scottdube/CNC_Vac_Pump/mech/Console_pcb.step

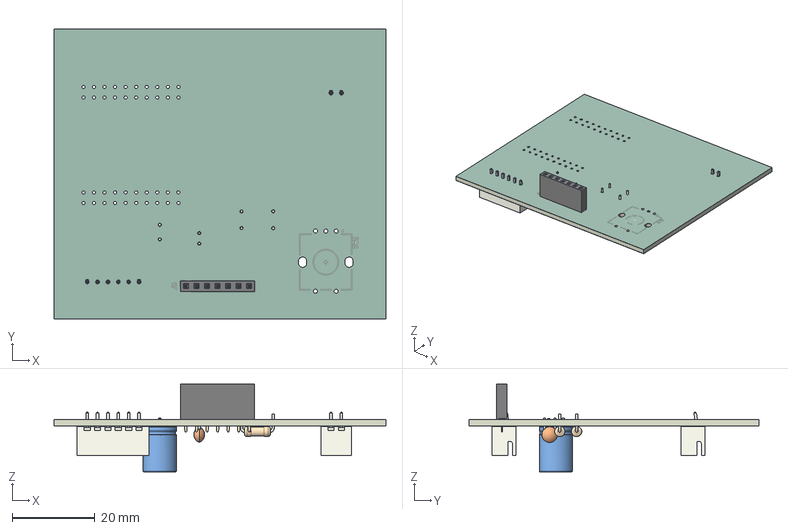
[picture p1: CAD file, 2026-08-21]
mech/Console_pcb.step
80.0 x 70.0 x 21.2 mm
PinSocket_1x07_P2.54mm_Vertical
JST_B6B_XH_A
C_Radial_D80mm_H115mm_P350mm
R_Axial_DIN0207_L63mm_D25mm_P762mm_Horizontal x 2
JST_B2B_XH_A
C_Disc_D38mm_W26mm_P250mm
Console_silkscreen x 2
Console_soldermask x 2
Console_PCB
