scottdube/CNC_Vac_Pump/PCB/Console/Console.kicad_pcb

## KiCad design PCB/Console/Console.kicad_pcb (2026-08-21)

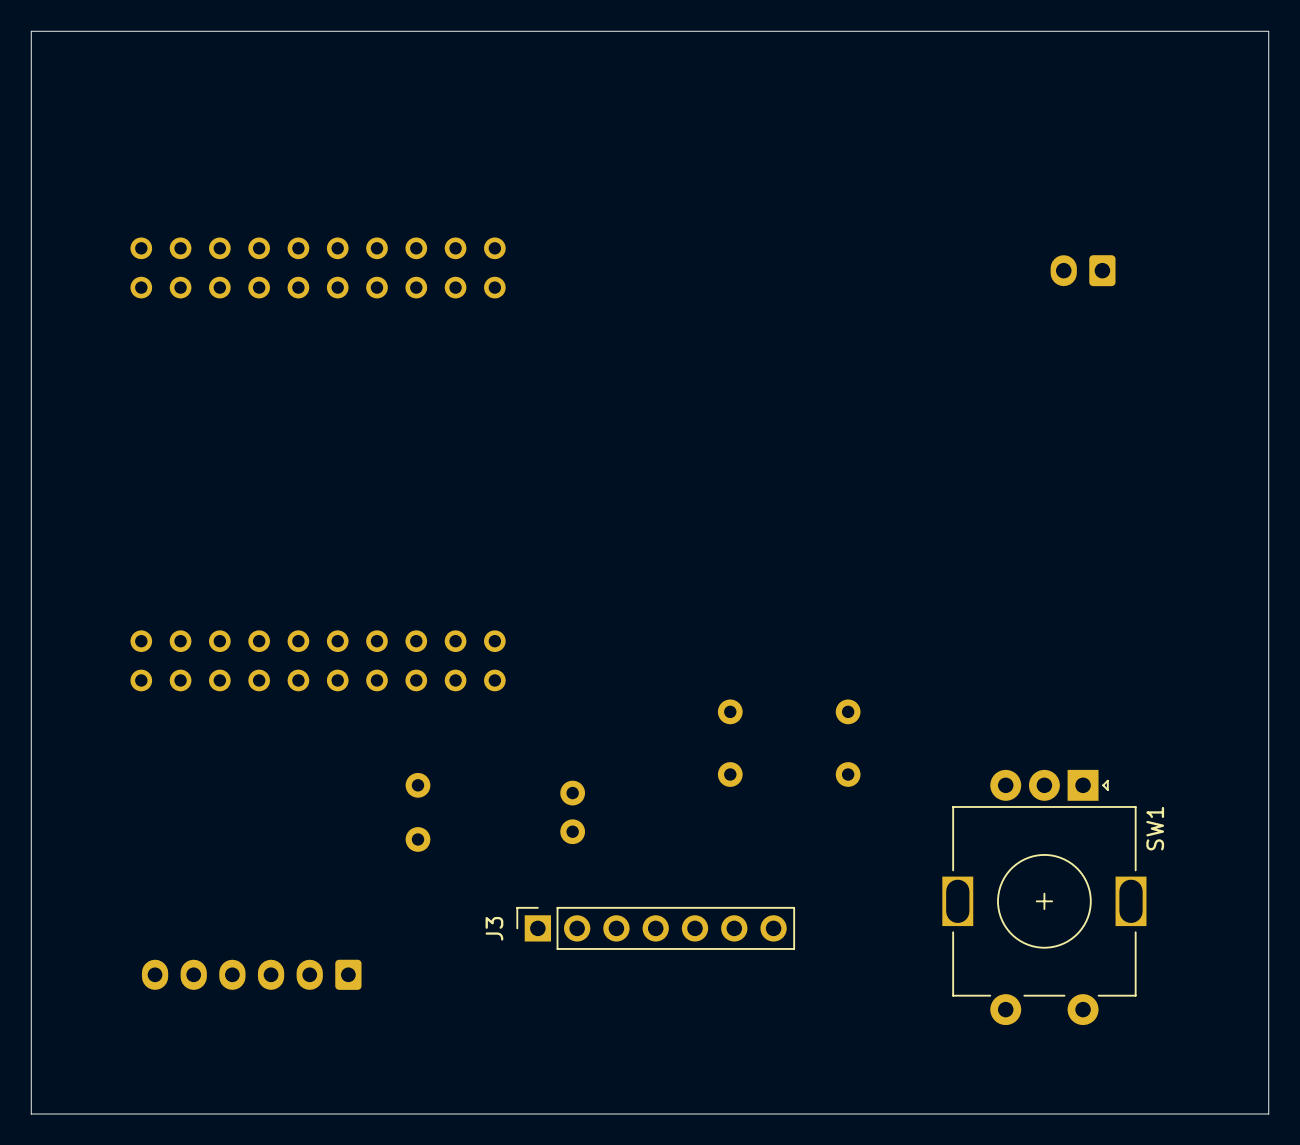
[picture p2: board Console.kicad_pcb from above]

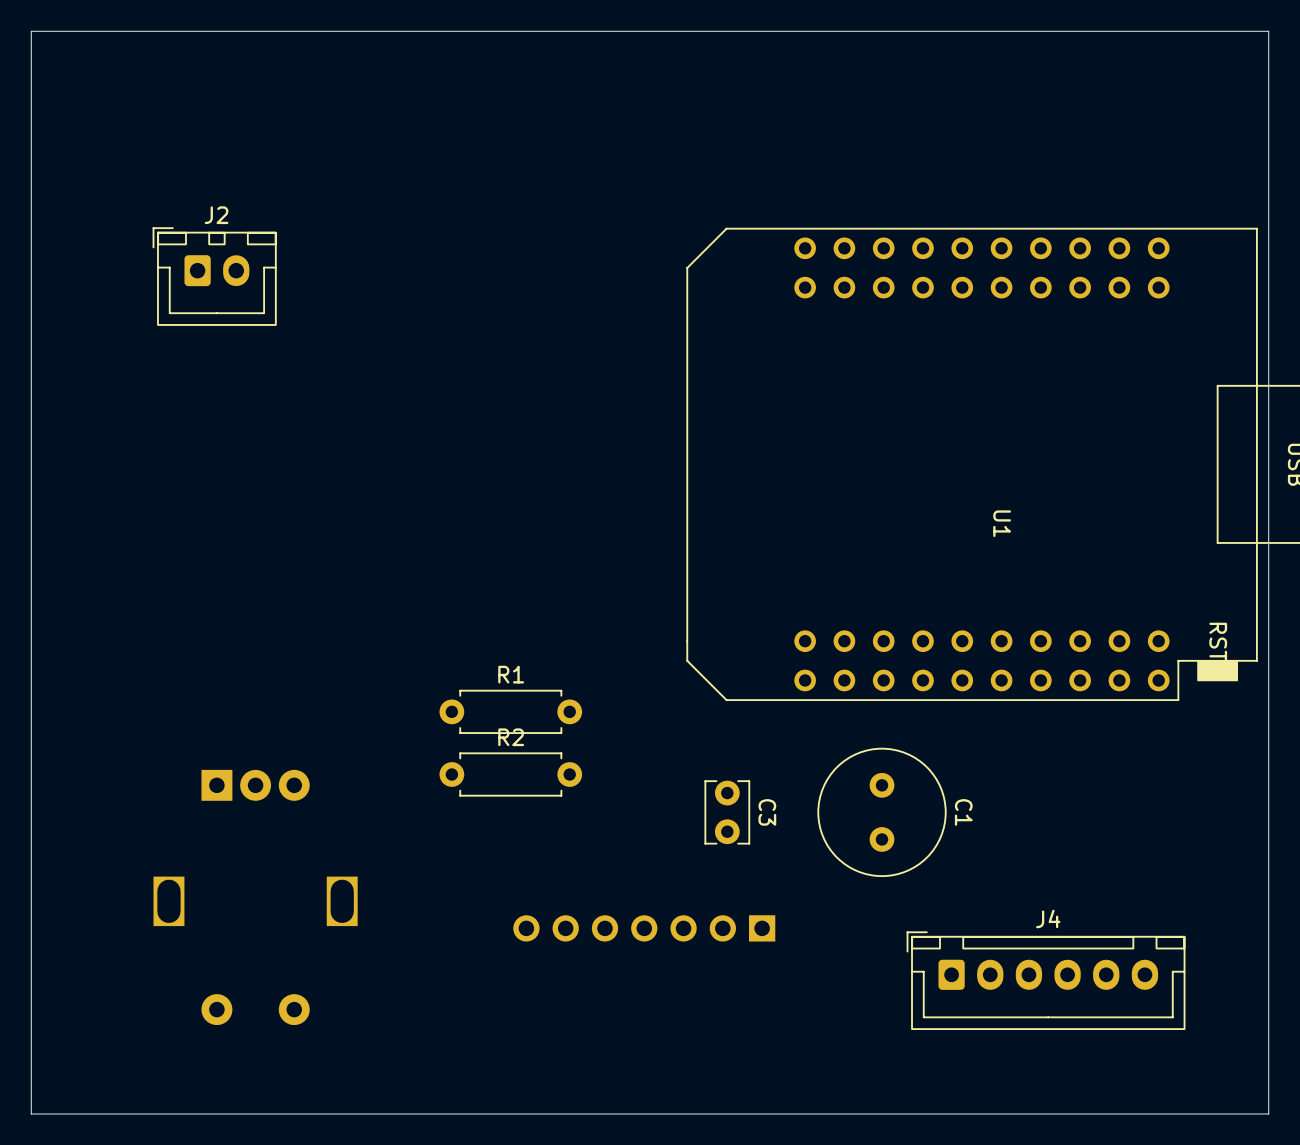
[picture p3: board Console.kicad_pcb from below]

Board: 2 copper layers, 80.0 x 70.0 mm, 9 parts (7 on the bottom side), 16 nets, no tracks yet.

Parts:
C1: 10uF; C_Radial_D8.0mm_H11.5mm_P3.50mm
C3: 100pF; C_Disc_D3.8mm_W2.6mm_P2.50mm
J2: Conn_01x02_Socket; JST_XH_B2B-XH-A_1x02_P2.50mm_Vertical
J3: Conn_01x07; PinSocket_1x07_P2.54mm_Vertical
J4: Conn_01x06; JST_XH_B6B-XH-A_1x06_P2.50mm_Vertical
R1: 5k; R_Axial_DIN0207_L6.3mm_D2.5mm_P7.62mm_Horizontal
R2: 10k; R_Axial_DIN0207_L6.3mm_D2.5mm_P7.62mm_Horizontal
SW1: RotaryEncoder_Switch_MP; RotaryEncoder_Alps_EC11E-Switch_Vertical_H20mm
U1: WeMos D1 Mini32; ESP32_mini

Connections:
/5Vdc: J2.1, J4.1
/5Vdc_switched: J2.2, U1.16 (Vcc)
/Alarm: J4.6, U1.30 (IO33)
/ENC_ChanA: SW1.A, U1.5 (IO25)
/ENC_ChanB: SW1.B, U1.7 (IO32)
/ENC_PB: SW1.S1, U1.3 (IO27)
/LCD_CS: J3.6, U1.33 (IO5)
/LCD_DC: J3.5, U1.10 (IO17)
/LCD_MOSI: J3.4, U1.31 (IO23)
/LCD_RST: J3.7, U1.12 (IO16)
/LCD_SClk: J3.3, U1.27 (IO18)
/LCD_Vcc: J3.1, U1.35 (3.3v)
/Vac_Pump: J4.5, U1.25 (IO26)
/Vac_Sensor: C1.1, C3.1, J4.3, R1.1
/Vacuum_Sig: R1.2, R2.1, U1.28 (IO35)
GND: C1.2, C3.2, J3.2, J4.2, J4.4, R2.2, SW1.C, SW1.MP, SW1.S2, U1.1 (Gnd), U1.14 (GND), U1.22 (GND)
