scottdube/CNC_Vac_Pump/(commit log)

2026-07-26 Baseline: as-validated bench config
    Alarm IO22->IO33 (matches validated hw); MPXV6115VC6U documented; title block + attribution; ERC clean (PWR_FLAGs, AC plug pins numbered); KiCad 10 format
    [Vac_Pump_Controller.kicad_sch]
2026-07-28 Rev2: fork baseline into Console + PowerBox projects
    [Console.kicad_pcb, Console.kicad_sch, PowerBox.kicad_pcb, PowerBox.kicad_sch]
2026-07-28 Console: strip to console-side, GX16-6 connector, ERC clean
    [Console.kicad_sch]
2026-07-29 Console: assign footprints (D1 Mini32 + JST XH + passives), verified pin mapping via F8
    [Console.kicad_pcb, Console.kicad_sch]
2026-07-29 Ignore KiCad .kicad_prl view-state files
2026-08-21 Untrack Console.kicad_prl
2026-08-21 Console: swap Waveshare pigtail for M128 7-pin socket (J3); F8 to PCB
    [Console.kicad_pcb, Console.kicad_sch]
2026-08-21 mech: add Console PCB STEP export
    Mechanical model of the console PCB, matching the J3 change in the previous
    commit - the Waveshare pigtail swapped for the M128 7-pin socket. Committed so
    the STEP and the electrical design cannot drift apart: a fit check done against
    a stale export is worse than no fit check, because it looks like verification.
    [Console_pcb.step]
